HydrogenRb/PurdueRMSuperCap/test bench.txt

### You don't need this! This is Hydrogen's note!

这个文件是为了SuperCap的测试所准备的，其中包含了superCap的测试表以及必要的知识

1.安装HAL和keil5的URL链接和方法
2.简单介绍一下CMSIS和MDKARM的不同（但是我也不太清楚这个部分）
3.362学生可以跳过：我们控制芯片输出高低电压，然后板子上面的电路和接口配合着输出各式各样的东西（比如配合蜂鸣器+MOS管可以输出声音，配合LED可以闪光）
4.CubeMX创建教程，我们主要要使用的有ADC、GPIO、TIM、UART
5.keil5编程、上传教程（小魔法棒）
6.给362学生：如果想要使用串口监视器，可以单独下载后使用

#下面是关于超级电容控制器的简单介绍
1.框图
2.常见工作情况
	电池1 电容0 电机0 待机>充电
	电池1 电容1 电机1 充电>待机
	电池0 电容1  电机1 待机>放电
	电池0  电容0 电机1->0 放电>反向充电
3.transfer function图
	ADC[4:0] -> PWM[3:0]

#Test Bench
###A
##本部分测试基本subsystem
0.通电测试检测是否有异常发热 检查
1.测试理想二极管
2.测试电压的ADC（分压器）//需要事先准备好STM32的代码
3.测试电流的采样（直接看采样电阻两端的电压）
4.测试电流采样IC的工作  //需要事先准备好STM32的代码
5.测试MOS驱动电路  //或许需要事先准备好STM32的代码

###B
##本部分测试充电基本功能
1.基本BUCK功能：将5V电压降为2V，通过负载仪检测效率，通过示波仪检测ripple（Note：记得设置可调电源的最大输出电流，防止弄坏MOSFET） //需要事先准备好STM32的代码
2.完整BUCK功能：将24V电压降为2V、10V、15V，通过负载仪检测效率，通过示波仪检测ripple，修改程序使ripple缩小 //需要事先准备好STM32的代码
3.限电流BUCK功能：调整负载仪的值，使电流限制在1A
4.1A充电测试（使用真实电容，同时测量输出ripple）

###C
##本部分测试放电基本功能
1.基本BOOST功能：将5V电压升成10V，通过负载仪检测效率，通过示波仪检测ripple  //需要事先准备好STM32的代码
2.完整BOOST功能：尝试将20V、15V、10V、5V、3V升压成24V，检测ripple
3.大电流BOOST功能：在输出2A的情况下完成上面的测试，同时input应该变化，检测ripple（note：去复习一下mosfet的电流限制？）

###D
##可读性功能测试（本功能和上面的独立）
1.完成代码，能够读取裁判系统数据，单独保存裁判系统的功率值（可以参考leo的代码）

##测试顺序：
A0 A1 A2 A3 A4 A5 B1 B2 C1 C2 B3 B4 C3
At least we can finish B2 before research conference
