HydrogenRb/PurdueRMSuperCap/(threads)

Thread 1 (2024-02-24):

Auxiliary voltage wrong (In A.1) (solved)

HydrogenRb, 2024-02-24:
Input voltage: 20V
Load: 0
DCDC: Turn off
Testing: A.1

The 1.6V and 3.3V net have 20V or 12V (The 12V seems to come from SY8501).

HydrogenRb, 2024-02-24:
I remove LM1117, current IC, and OP-Amp. Then, resolder the LM1117, The voltage (12V, 3.3V) seemed well. I will resolder the OP-Amp on Monday to see the 1.6V.

HydrogenRb, 2024-02-26:
I thought it was solder problems. Fixed

Closed 2024-03-21.

Thread 2 (2024-02-26):

A1 and A2 finished

HydrogenRb, 2024-02-26:
A.1 and A.2 finished
But I remove the current sensor for ADC1 and ADC2, we  can solder them later

Closed 2024-03-21.
